kenwer/bird-weighing-capsules/(commit log)

2026-04-20 Minor dimension adjustments
    [bird_weighing_capsules.scad]
2026-05-15 Add small capsule & adjust sizes
    [bird_weighing_capsules.scad]
